Wang-Derr/ARDRUMINO/hw_val/hw_val.h

/*
 * This file is part of the ARDSEQUINO project.
 *
 * ARDSEQUINO is free software: you can redistribute it and/or modify it under the terms of the GNU General Public License as published by the Free Software Foundation, either version 3 of the License, or (at your option) any later version.
 *
 * ARDSEQUINO is distributed in the hope that it will be useful, but WITHOUT ANY WARRANTY; without even the implied warranty of MERCHANTABILITY or FITNESS FOR A PARTICULAR PURPOSE. See the GNU General Public License for more details.
 *
 * You should have received a copy of the GNU General Public License along with ARDSEQUINO. If not, see <https://www.gnu.org/licenses/>. 
 */

#ifndef ARDRUMINO_H
#define ARDRUMINO_H

const unsigned long sw_debounce_time = 10;

const byte NANO_pot_0 = A0;
const byte NANO_pot_1 = A1;
const byte NANO_pot_2 = A2;
const byte NANO_pot_3 = A3;

const byte NANO_sw0_pin = 12; // of the 17 key switches, one is connected directly to the Nano while the rest are routed through the SX1509 GPIO expander

const byte NANO_enc0_ch0 = 4;
const byte NANO_enc0_ch1 = 3;
const byte NANO_enc0_sw = 5;

const byte NANO_enc1_ch0 = 7;
const byte NANO_enc1_ch1 = 6;
const byte NANO_enc1_sw = 8;

const byte NANO_enc2_ch0 = 10;
const byte NANO_enc2_ch1 = 9;
const byte NANO_enc2_sw = 11;

const byte SX1509_int_pin = 2;

const byte SX1509_sw0_pin = 0; // Button connected to 0 (Active-low button)
const byte SX1509_sw1_pin = 1;
const byte SX1509_sw2_pin = 2;
const byte SX1509_sw3_pin = 3;
const byte SX1509_sw4_pin = 4;
const byte SX1509_sw5_pin = 5;
const byte SX1509_sw6_pin = 6;
const byte SX1509_sw7_pin = 7;
const byte SX1509_sw8_pin = 8;
const byte SX1509_sw9_pin = 9;
const byte SX1509_sw10_pin = 10;
const byte SX1509_sw11_pin = 11;
const byte SX1509_sw12_pin = 12;
const byte SX1509_sw13_pin = 13;
const byte SX1509_sw14_pin = 14;
const byte SX1509_sw15_pin = 15;

const byte SX1509_ADDR = 0x3E;
const byte HT16K33_ADDR = 0x70;

const uint8_t enc_map_table[][2] =
        {
            {8, 0},
            {9, 0},
            {10, 1},
            {11, 2},
            {11, 3},
            {11, 4},
            {11, 5},
            {10, 6},
            {9, 7},
            {8, 7},
            {7, 7},
            {6, 7},
            {5, 6},
            {4, 5},
            {4, 4},
            {4, 3},
            {4, 2},
            {5, 1},
            {6, 0},
            {7, 0},
        };

const PROGMEM uint8_t
    enc0_bmp[] =
    {
        B11101110, B11101110,
        B10001010, B10001010,
        B11001010, B10001010,
        B10001010, B10001010,
        B11101010, B11101110,
        B00000000, B00000000,
        B00000000, B00000000,
        B00000000, B00000000,
    },
    enc1_bmp[] =
    {
        B11101110, B11101000,
        B10001010, B10001000,
        B11001010, B10001000,
        B10001010, B10001000,
        B11101010, B11101000,
        B00000000, B00000000,
        B00000000, B00000000,
        B00000000, B00000000,
    },
    enc2_bmp[] =
    {
        B11101110, B11101110,
        B10001010, B10000010,
        B11001010, B10001110,
        B10001010, B10001000,
        B11101010, B11101110,
        B00000000, B00000000,
        B00000000, B00000000,
        B00000000, B00000000,
    },
    sw0_bmp[] =
    {
        B11101000, B10111000,
        B10001000, B10101000,
        B11101010, B10101000,
        B00101010, B10101000,
        B11101111, B10111000,
        B00000000, B00000000,
        B00000000, B00000000,
        B00000000, B00000000,
    },
    sw_1_bmp[] =
    {
        B11101000, B10100000,
        B10001000, B10100000,
        B11101010, B10100000,
        B00101010, B10100000,
        B11101111, B10100000,
        B00000000, B00000000,
        B00000000, B00000000,
        B00000000, B00000000,
    },
    sw_2_bmp[] =
    {
        B11101000, B10111000,
        B10001000, B10001000,
        B11101010, B10111000,
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
    err_bmp[] =
    {
        B11101100, B11000000,
        B10001010, B10100000,
        B11001100, B11000000,
        B10001010, B10100000,
        B11101010, B10100000,
        B00000000, B00000000,
        B00000000, B00000000,
        B00000000, B00000000,
    };


#endif  // ARDRUMINO_H
