Wang-Derr/ARDRUMINO/(commit log)

2024-09-13 Completed initial Circuit design and developed test code to validate the components of an assembled unit
2024-09-18 Fix: interrupts are now limited to setting flags to avoid spending too much time within them.
    [hw_val.h, hw_val.ino]
2024-12-10 Add links for 3D modeled enclosure parts
2025-01-22 fix: address error for global MIDI knob
    [ARDSEQUINO.ino]
2025-01-23 fix: sequencer page tracking occasionally dissappearing
    [ARDSEQUINO.ino]
2025-01-28 Fix: MIDI clock and sequencer issues, updated README
    [ARDSEQUINO.h, ARDSEQUINO.ino]
