Wang-Derr/ARDRUMINO/assets/Images/knobs_wired.jpg

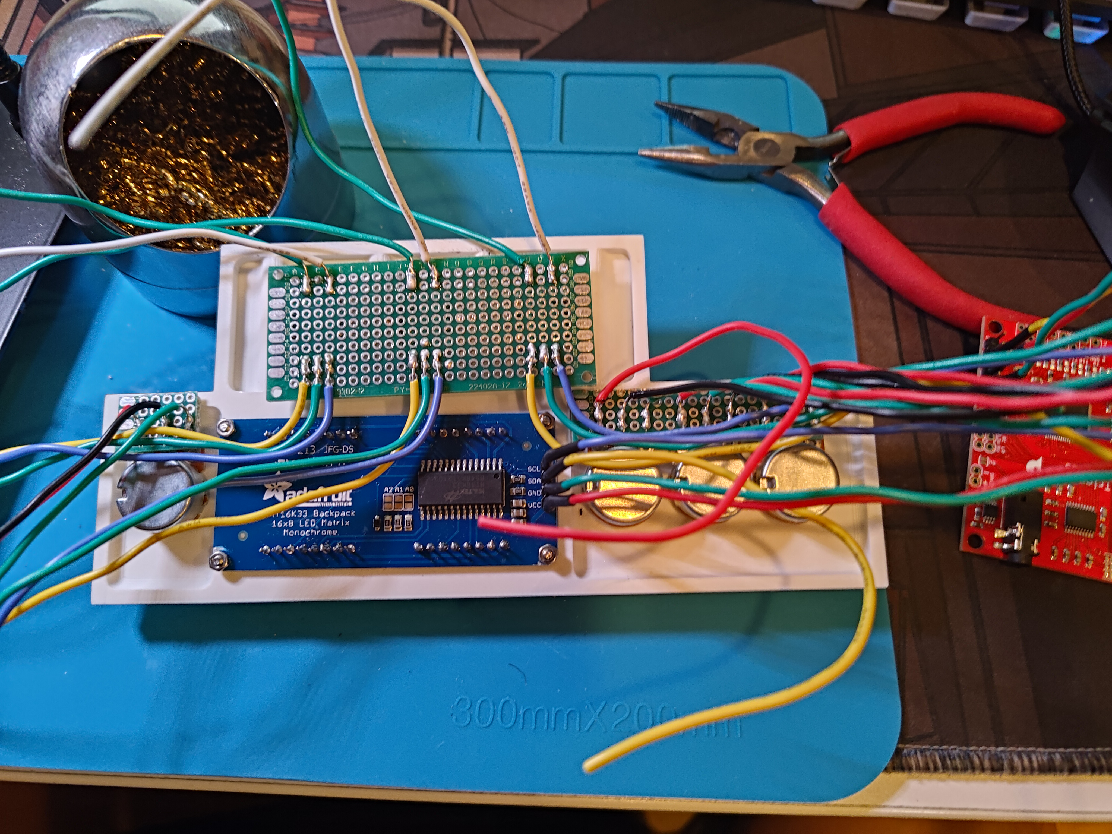
[picture p4: assets/Images/knobs_wired.jpg]
assets/Images/knobs_wired.jpg
