Wang-Derr/ARDRUMINO/assets/Images/testing_midi.jpg

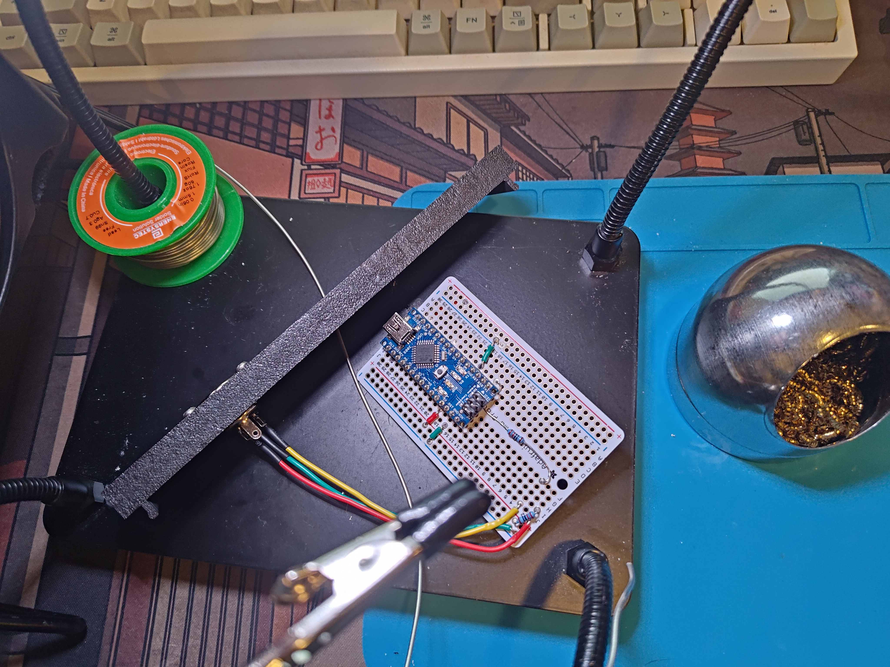
[picture p8: assets/Images/testing_midi.jpg]
assets/Images/testing_midi.jpg
