Wang-Derr/ARDRUMINO/assets/Images/mid-assembly_top.jpg

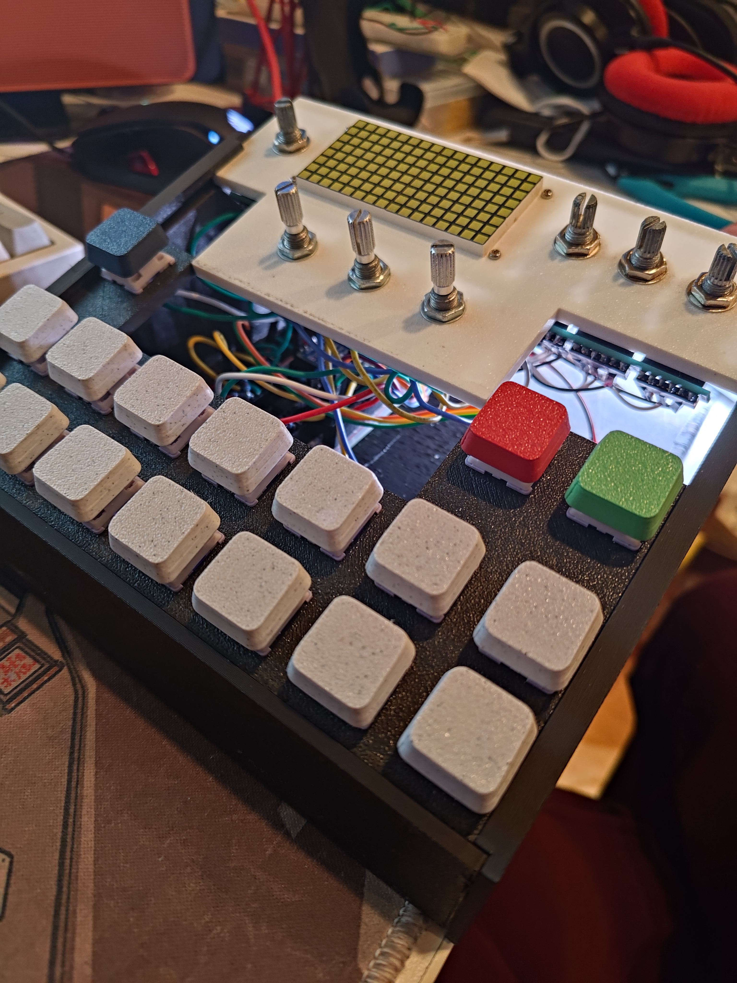
[picture p10: assets/Images/mid-assembly_top.jpg]
assets/Images/mid-assembly_top.jpg
